diogo0001/PI_III/cronograma.md

## Cronograma de atividades

| | Semana 1 | Semana 2 | Semana 3 | Semana 4 | Semana 5 |
|---|---|---|---|---|---|
|Setembro| Freq PWM stm32 (p/ VCO) | Ler MIDI-RX stm32 / Alimentar VCO-CI com PWM  |MIDI-Notas stm32/ 2 CIs-somador  | Notas-PWM stm32 / VCF | X |
|Outubro | LFO  / Envelope VCF | Controles  / VCA  | Envelope VCA | Ajustes | Layout da placa do circuito |
|Novembro| Teste placa  | Ajustes  | Placa | Montagem  / Afinação final | X |
|Dezembro| |  |  |  |  |
