diogo0001/PI_III/STM32_docs_codes/esq stm.PNG

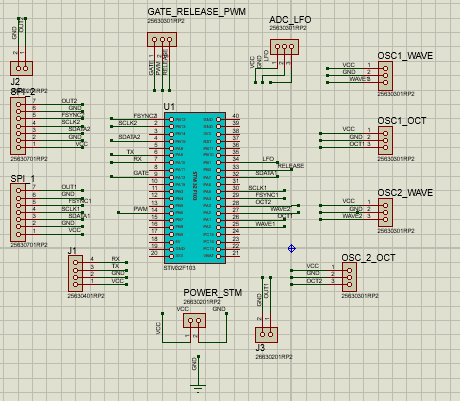
STM32_docs_codes/esq stm.PNG
