diogo0001/PI_III/Synth_docs_sources/LP_HP.jpg

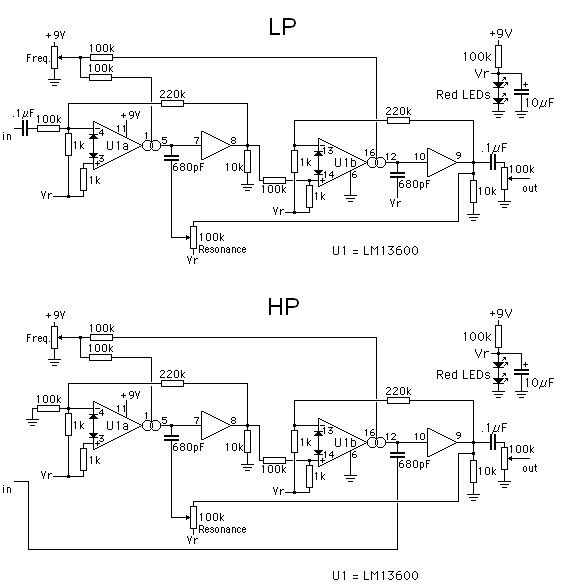
Synth_docs_sources/LP_HP.jpg
