diogo0001/PI_III/Synth_docs_sources/VCA/2cd8b64e2ba8f142182b0d7f99448446.png

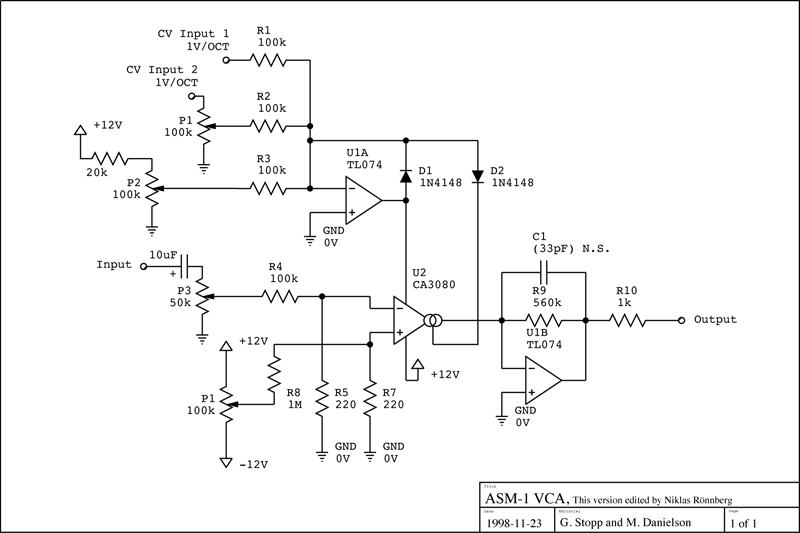
Synth_docs_sources/VCA/2cd8b64e2ba8f142182b0d7f99448446.png
