diogo0001/PI_III/Synth_docs_sources/VCA/110vca_645.gif

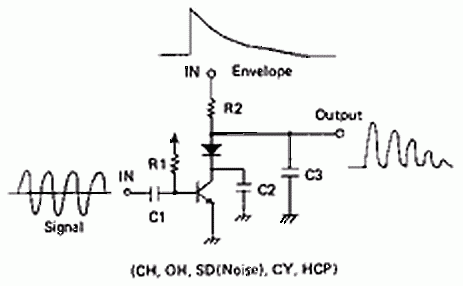
Synth_docs_sources/VCA/110vca_645.gif
