diogo0001/PI_III/Synth_docs_sources/VCA/ssm2164-dual-vca-schematic.png

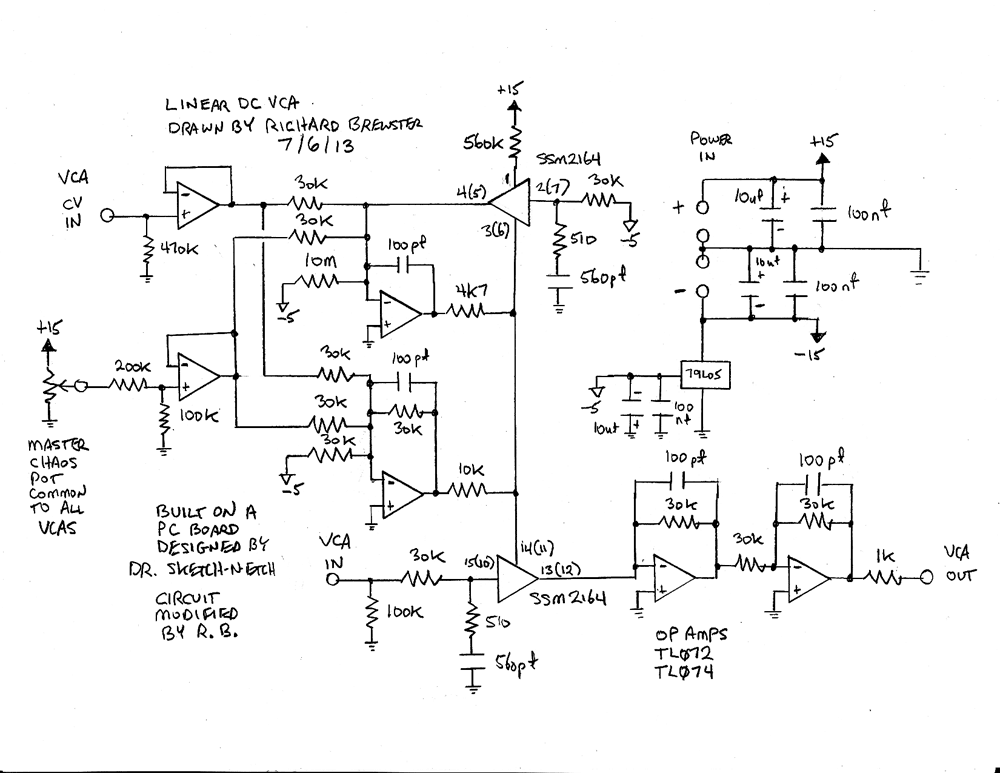
Synth_docs_sources/VCA/ssm2164-dual-vca-schematic.png
