diogo0001/PI_III/Synth_docs_sources/VCA/vca1.jpg

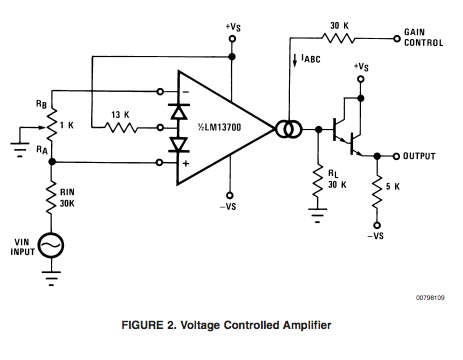
Synth_docs_sources/VCA/vca1.jpg
