diogo0001/PI_III/Synth_docs_sources/VCA/vca-f3.gif

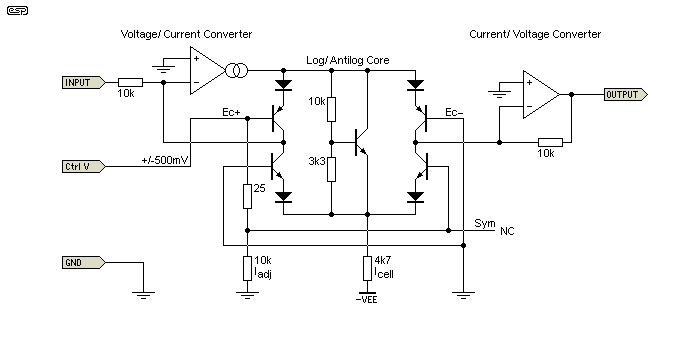
Synth_docs_sources/VCA/vca-f3.gif
