diogo0001/PI_III/Synth_docs_sources/VCA/YuVCASimplified.png

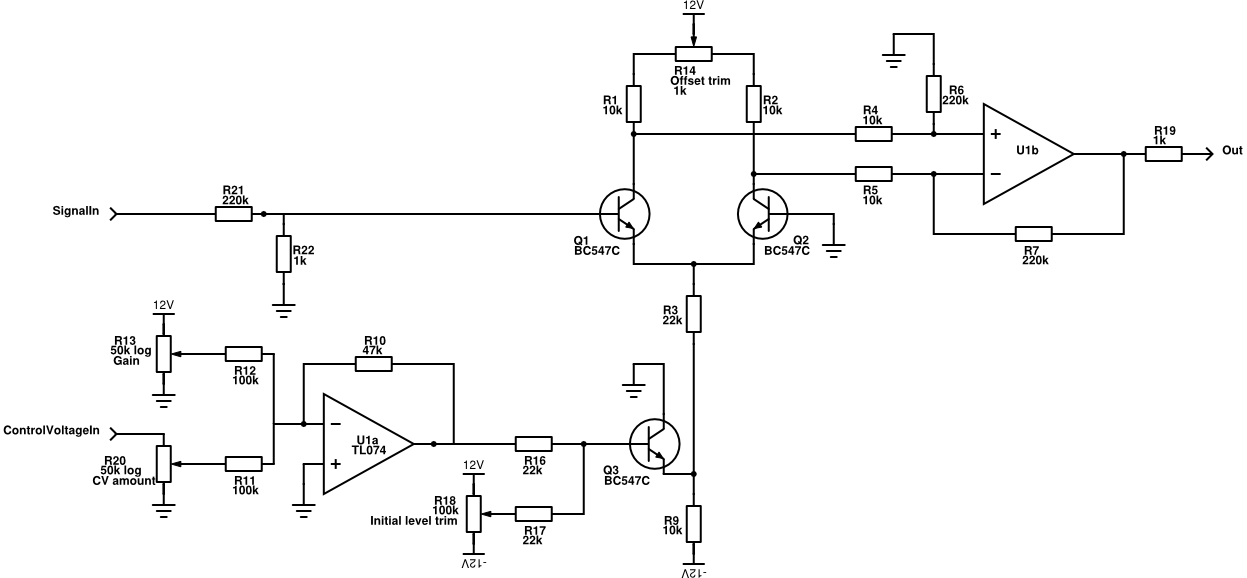
Synth_docs_sources/VCA/YuVCASimplified.png
