diogo0001/PI_III/Synth_docs_sources/Vcf0211a.gif

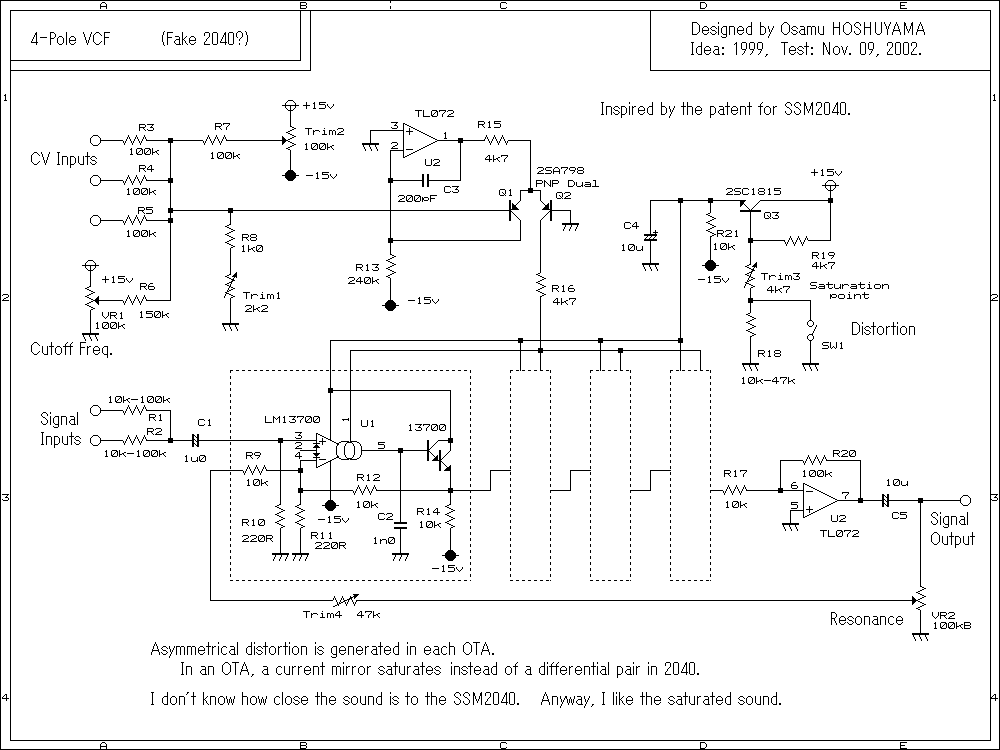
Synth_docs_sources/Vcf0211a.gif
