diogo0001/PI_III/Synth_docs_sources/VCF/t_ultrasimplevcf_132.png

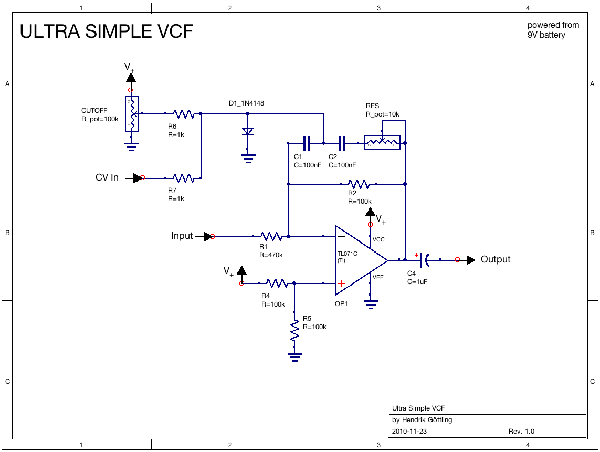
Synth_docs_sources/VCF/t_ultrasimplevcf_132.png
