diogo0001/PI_III/Synth_docs_sources/VCF/vcf.gif

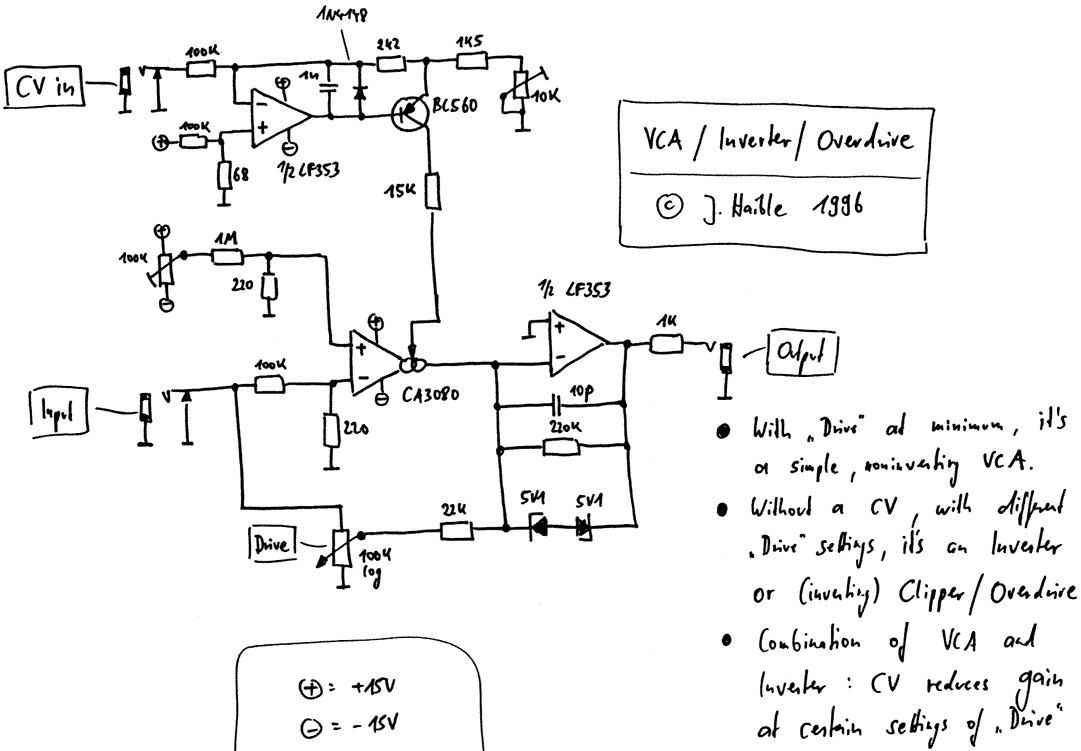
Synth_docs_sources/VCF/vcf.gif
