diogo0001/PI_III/Synth_docs_sources/VCF/vcf_sallen.gif

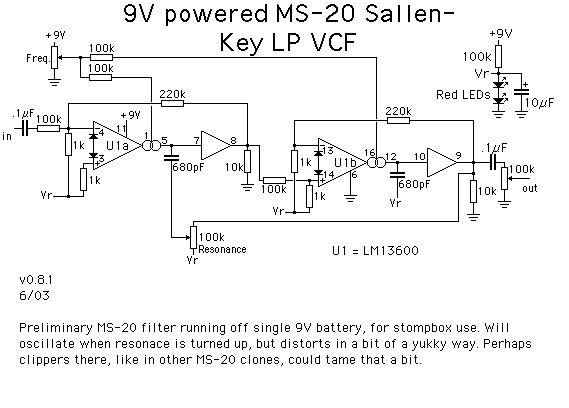
Synth_docs_sources/VCF/vcf_sallen.gif
