diogo0001/PI_III/Synth_docs_sources/VCF/vcfjan2006_schematic_pg2.gif

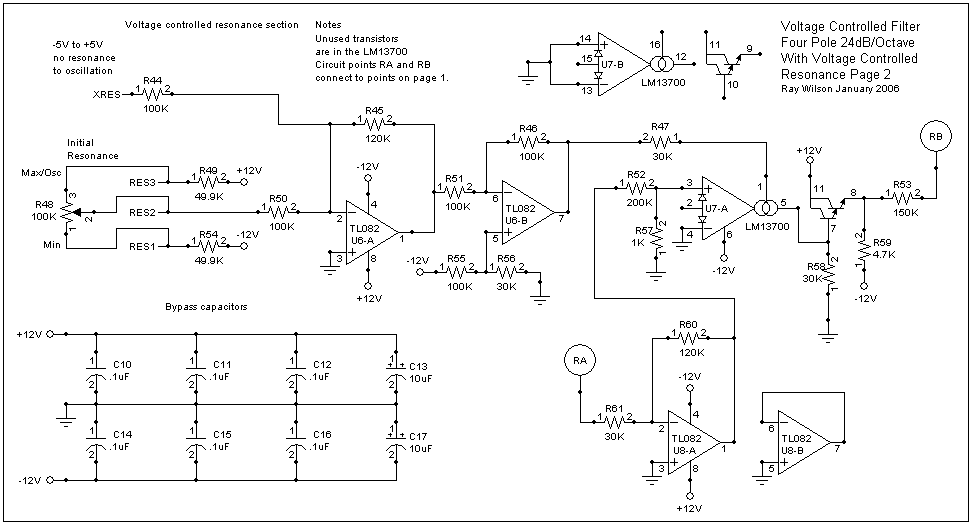
Synth_docs_sources/VCF/vcfjan2006_schematic_pg2.gif
