diogo0001/PI_III/VCA_test/readme.md

# Teste do circuito VCA

O circuito VCA é responsável pela amplificação final, e junto com o envelope produz as modulações 
de amplitude que podem caracterizar o som desejado. O circuito do envelope produz a envoltória que irá controlar
a dinâmica da amplitude do VCA em função do tempo. O VCA possui a entrada do sinal do áudio e a entrada 
para a tensão de controle, que virá do envelope e também do LFO.

Os parâmetros do envelope são:

  - Atack: tempo para o sinal atingir o seu máximo.
  - Decay: tempo para o sinal decair até a amplitude de sustain.
  - Sustain: amplitude de sustentação do sinal.
  - Release: tempo de decaimento do sustain até zero depois que a nota para de ser tocada.

## Circuito de simulação

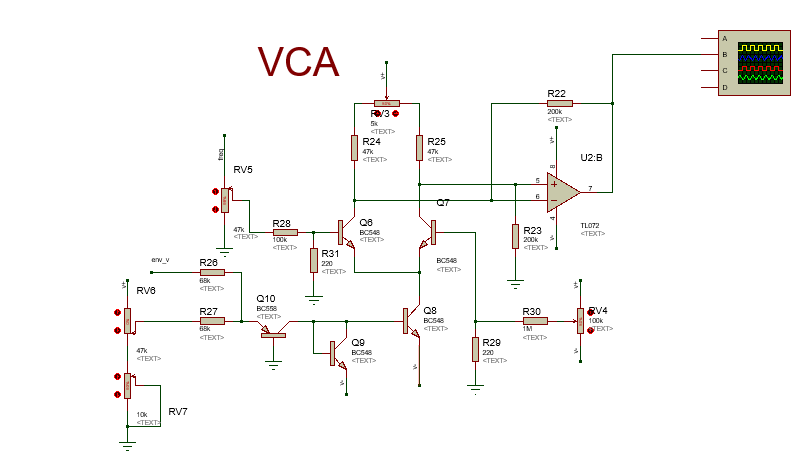
[picture p34: VCA_test/VCA_circuit.PNG]


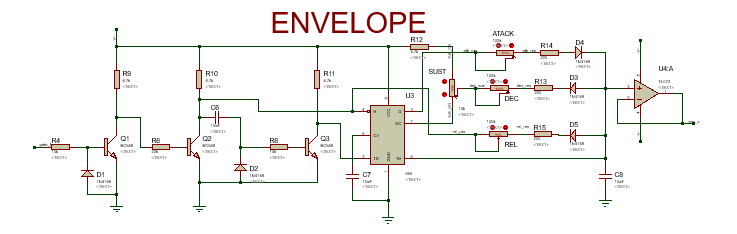
[picture p35: VCA_test/envelope_circuit.PNG]


### Resultado da simulação:

Em amarelo: sinal do envelope.

Em azul: sinal de áudio modulado.

Em rosa: sinal de áudio original.

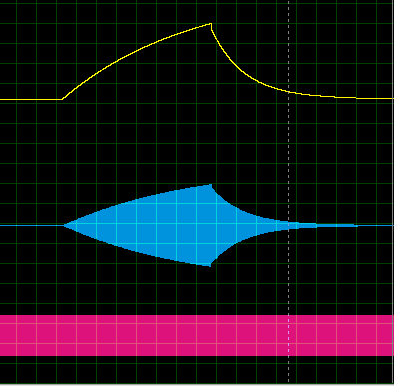
[picture p36: VCA_test/vca_envelope.PNG]


## Resultados práticos

### Envelope
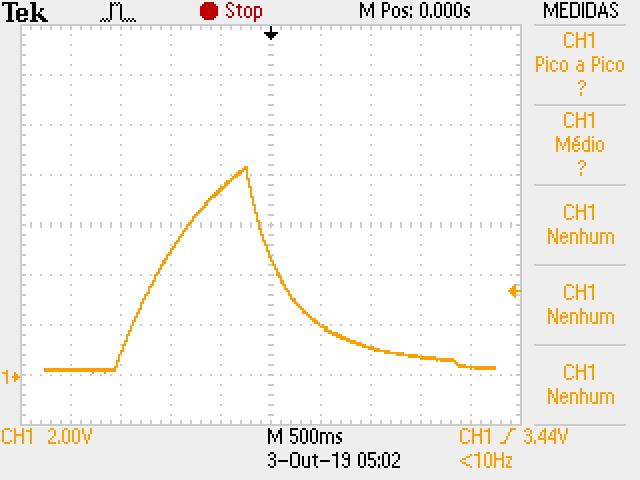
[picture p37: VCA_test/TEK0000.JPG]


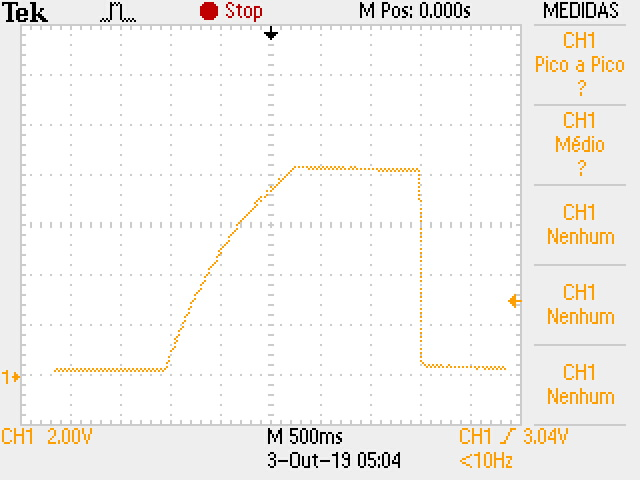
[picture p38: VCA_test/TEK0001.JPG]


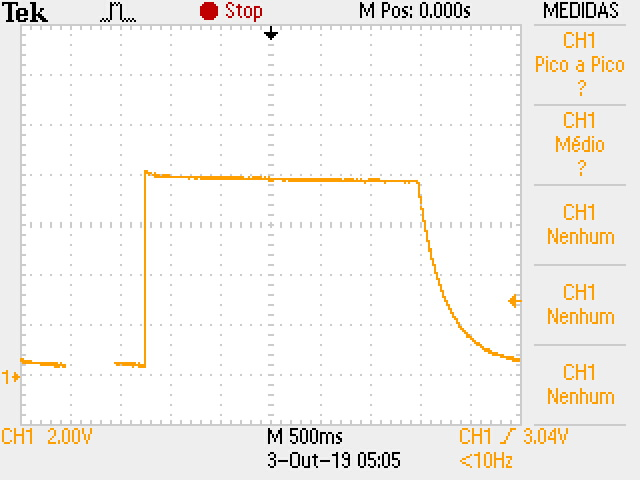
[picture p39: VCA_test/TEK0002.JPG]


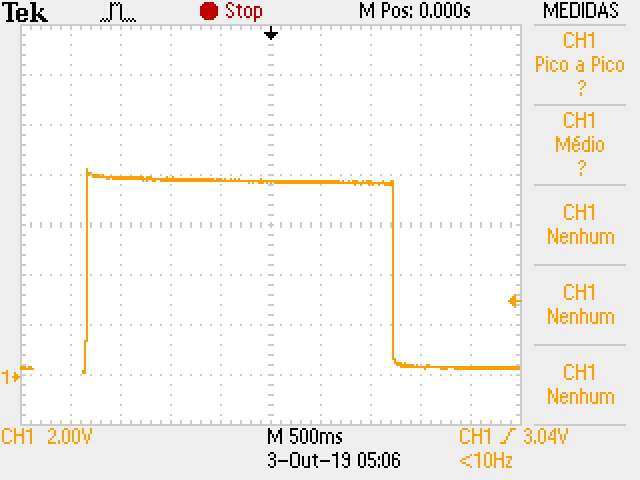
[picture p40: VCA_test/TEK0003.JPG]


### VCA

Teste do sinal com modulação por LFO

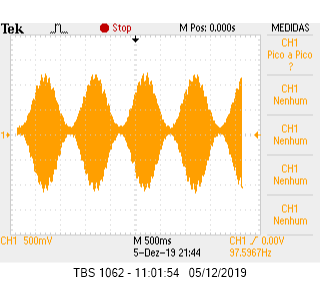
[picture p41: VCA_test/vca_lfo_osciloscope.png]
