diogo0001/PI_III/Board_layout/Layout_To_print/niveis_vcf.pdf

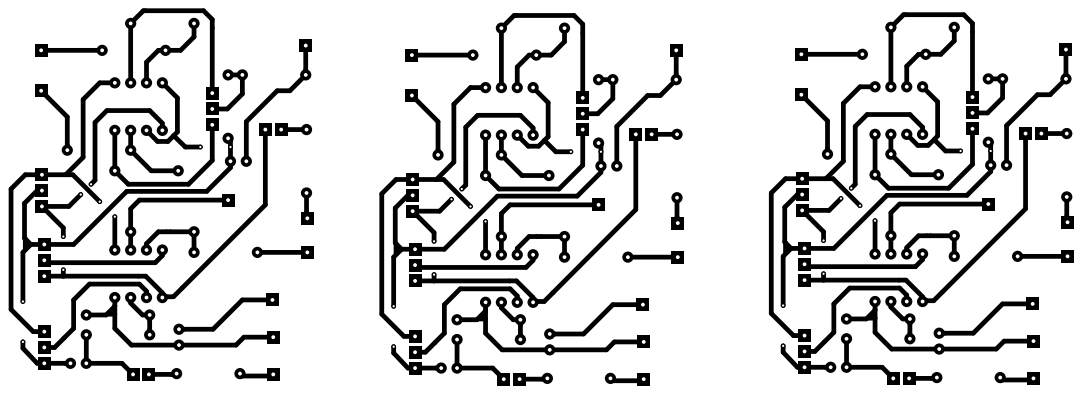
[picture p52: page 1]
