diogo0001/PI_III/Board_layout/Layout_To_print/niveis_vcf_silk.pdf

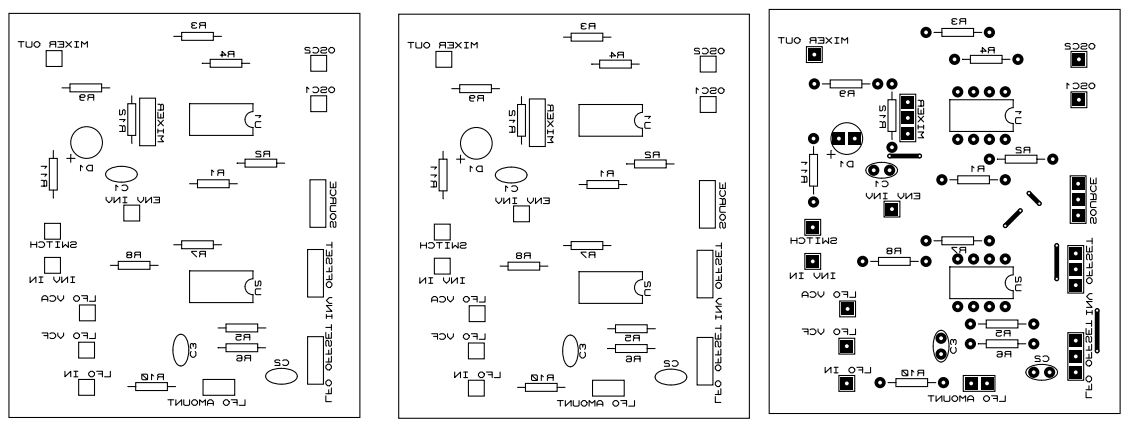
[picture p53: page 1]
