diogo0001/PI_III/Board_layout/Layout_To_print/vcf.pdf

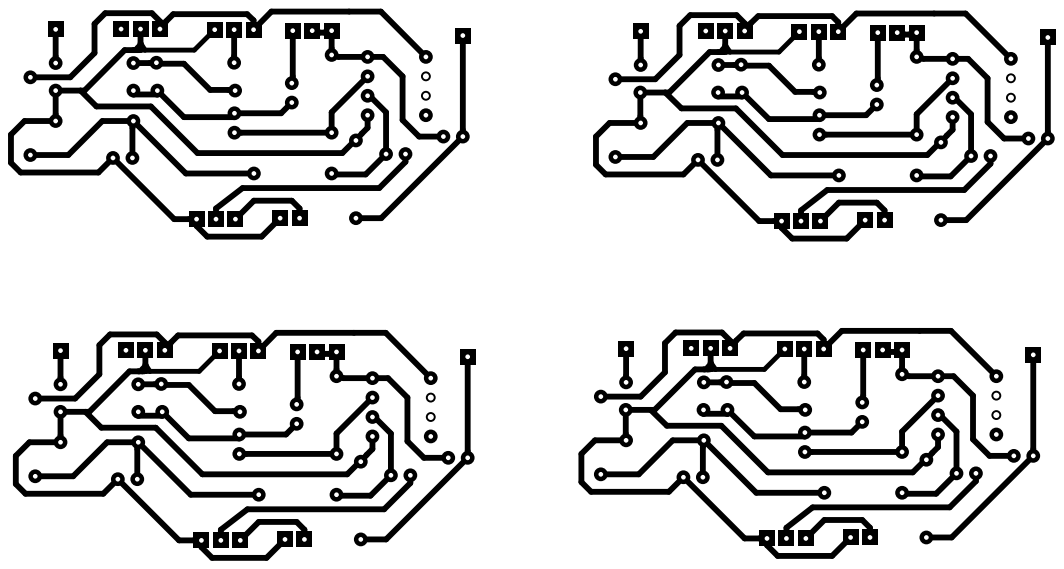
[picture p54: page 1]
