diogo0001/PI_III/Board_layout/Layout_To_print/vcf_silk.pdf

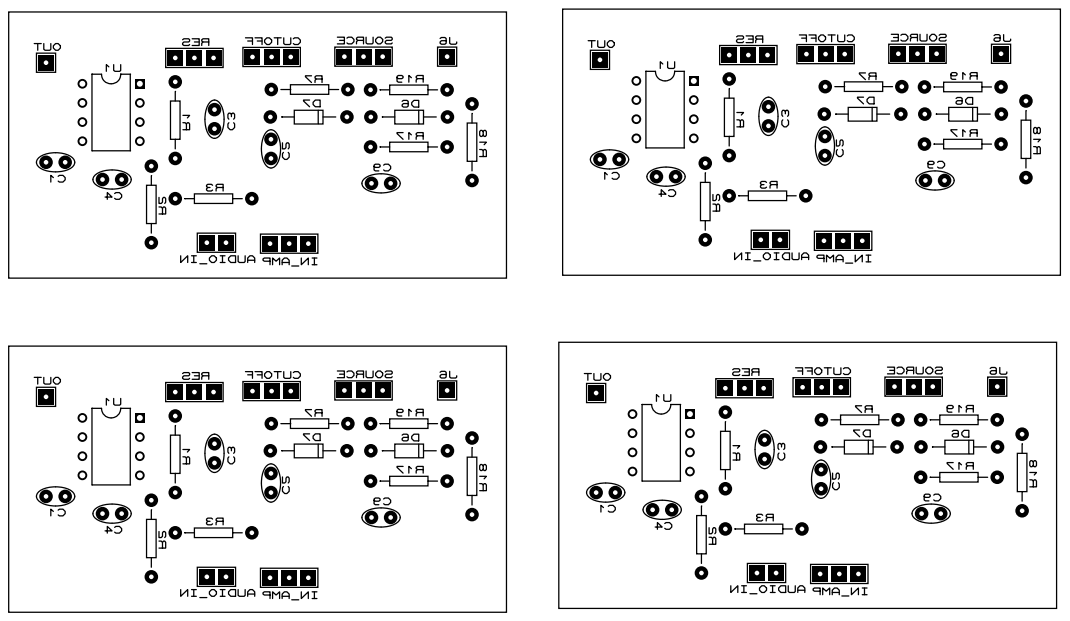
[picture p55: page 1]
