diogo0001/PI_III/Synth_docs_sources/VCF/DIRT_Schematic_2.2.pdf

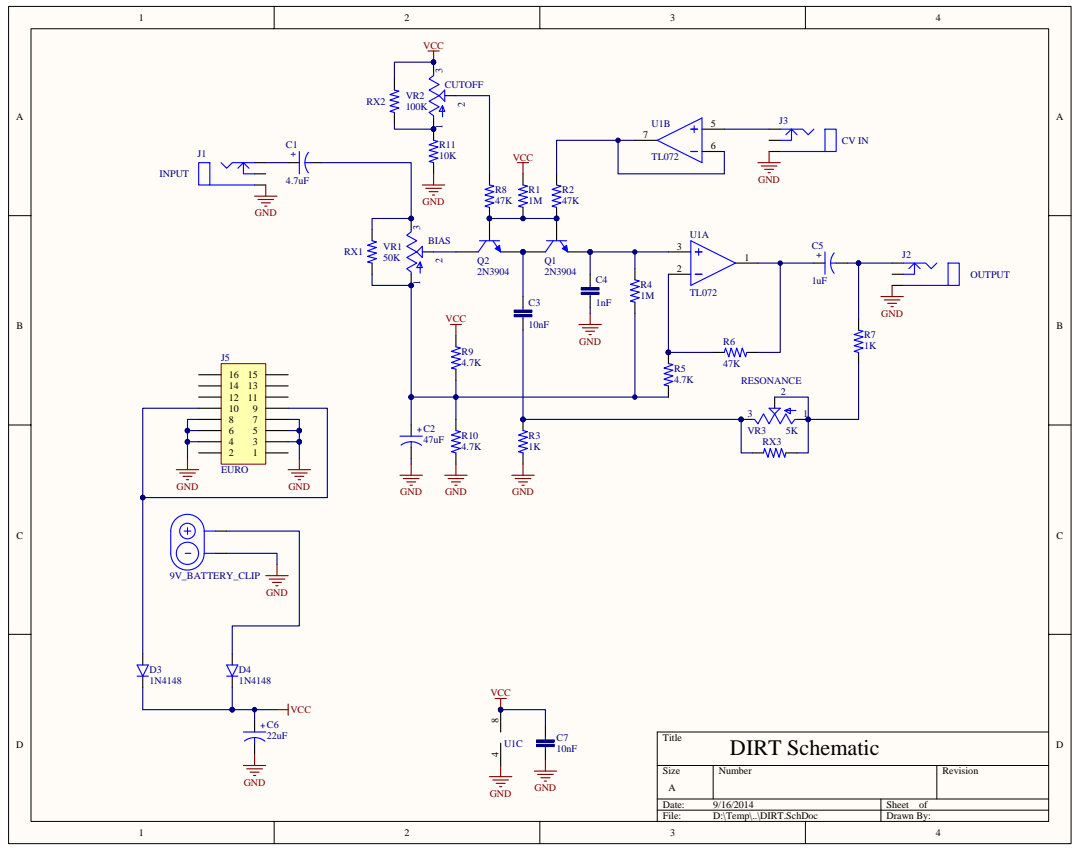
[picture p56: page 1]

Size A | Number | Revision

Date: 9/16/2014 | Sheet of
File: D:\Temp\..\DIRT.SchDoc | Drawn By:
