diogo0001/PI_III/Board_layout/Layout_To_print/vca.pdf

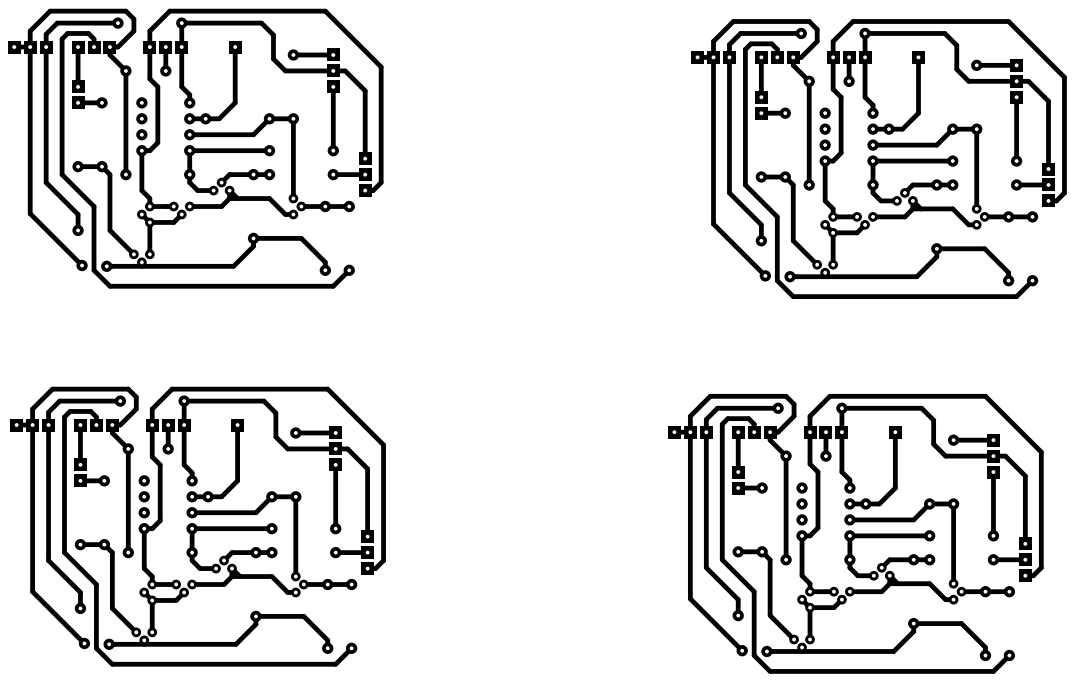
[picture p57: page 1]
