diogo0001/PI_III/Board_layout/Layout_To_print/vca_silk.pdf

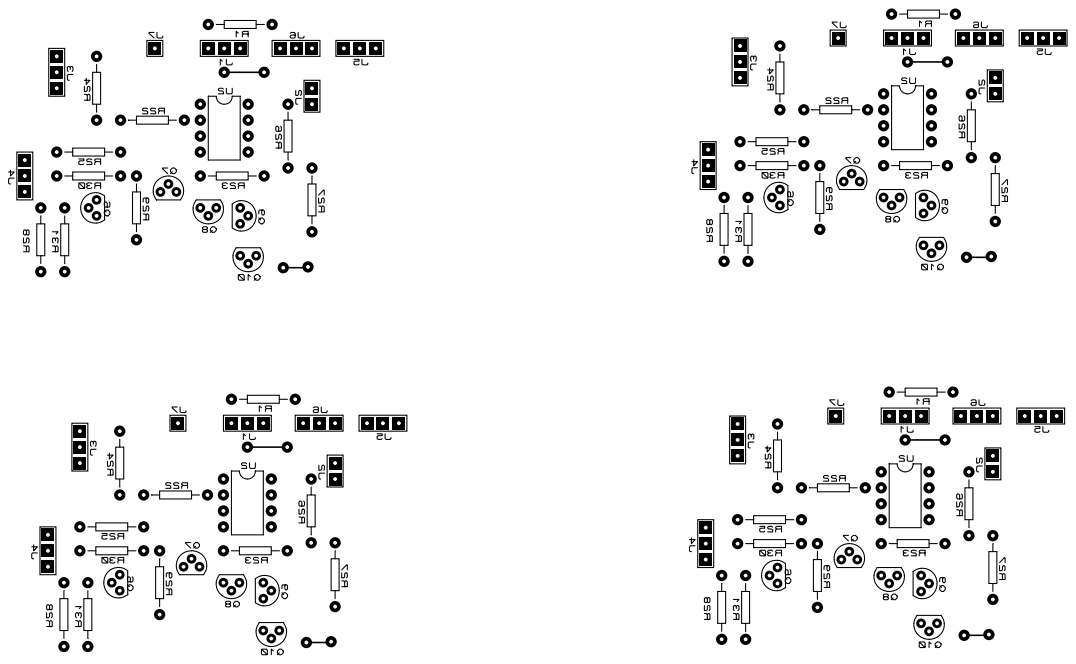
[picture p58: page 1]
