diogo0001/PI_III/Board_layout/Layout_To_print/envelope.pdf

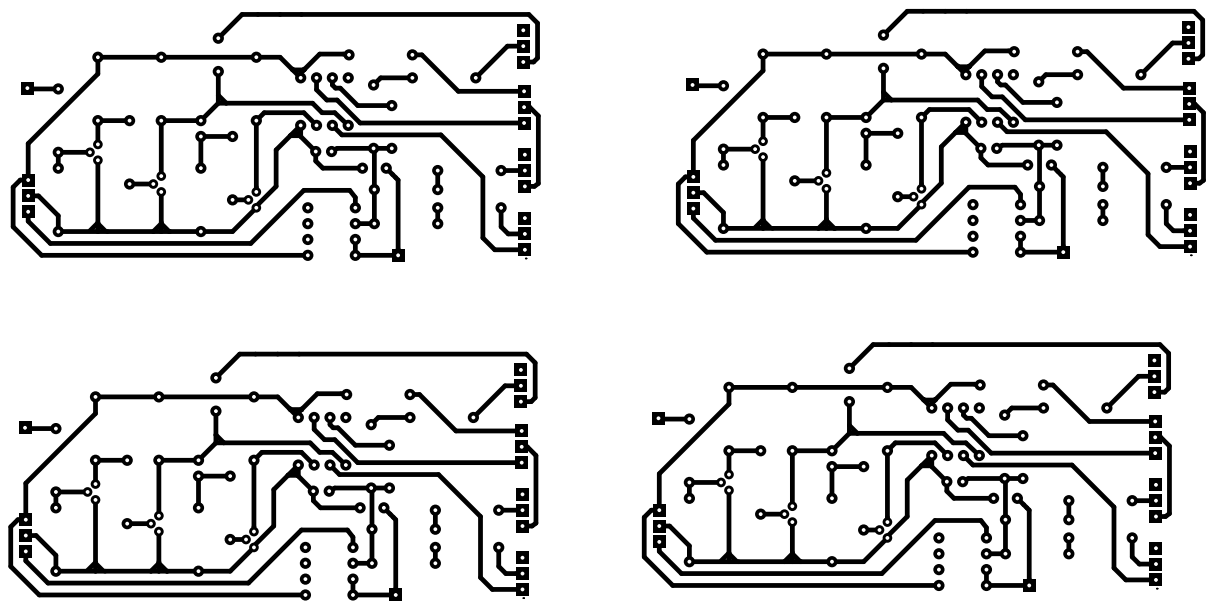
[picture p59: page 1]
