diogo0001/PI_III/Board_layout/Layout_To_print/envelope_silk.pdf

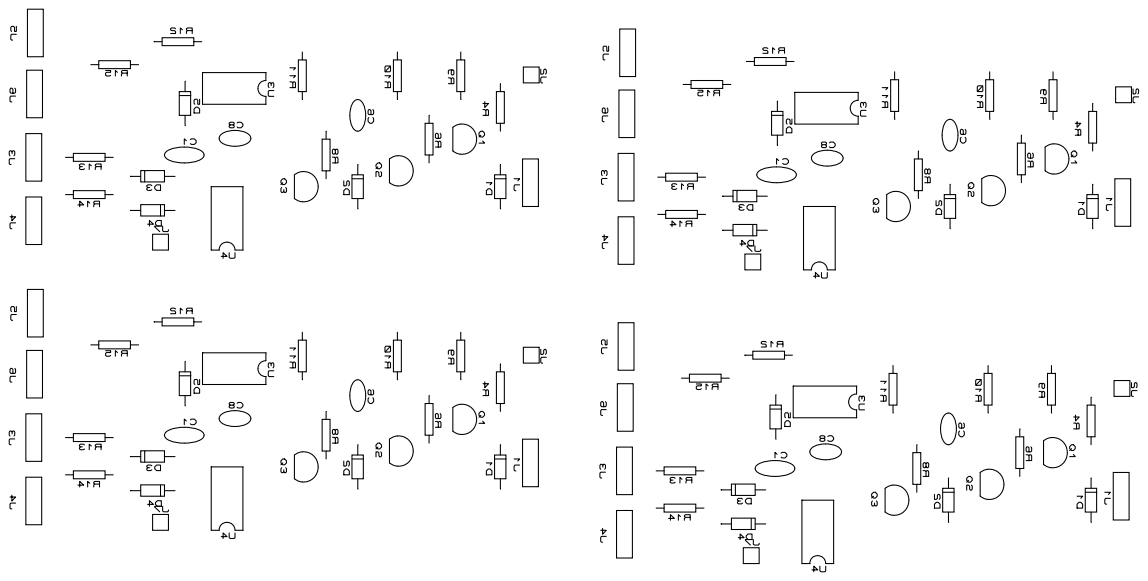
[picture p60: page 1]
