diogo0001/PI_III/STM32_docs_codes/code stm32.pdf

main.c

1 /* USER CODE BEGIN Header */
2 /**
3 ******************************************************************************
4 | * @file | : main.c
5 | * @brief | : Main program body
6 ****************************************************************************** 7 * @attention
8 *
9 * <h2><center>&copy; Copyright (c) 2019 STMicroelectronics.
10 * All rights reserved.</center></h2>
11 *
12 * This software component is licensed by ST under BSD 3-Clause license, 13 * the "License"; You may not use this file except in compliance with the 14 * License. You may obtain a copy of the License at:
15 | * | opensource.org/licenses/BSD-3-Clause
16 *
17 ****************************************************************************** 18 */
19 /* USER CODE END Header */
20
21 /* Includes ------------------------------------------------------------------*/ 22 #include "main.h"
23
24 /* Private includes ----------------------------------------------------------*/ 25 /* USER CODE BEGIN Includes */
26 #include "math.h"
27 /* USER CODE END Includes */
28
29 /* Private typedef -----------------------------------------------------------*/ 30 /* USER CODE BEGIN PTD */
31
32 /* USER CODE END PTD */
33
34 /* Private define ------------------------------------------------------------*/ 35 /* USER CODE BEGIN PD */
36
37 /* USER CODE END PD */
38
39 /* Private macro -------------------------------------------------------------*/ 40 /* USER CODE BEGIN PM */
41
42 /* USER CODE END PM */
43
44 /* Private variables ---------------------------------------------------------*/ 45 ADC_HandleTypeDef hadc1;
46 ADC_HandleTypeDef hadc2;
47
48 SPI_HandleTypeDef hspi1; 49 SPI_HandleTypeDef hspi2; 50
51 TIM_HandleTypeDef htim3; 52 TIM_HandleTypeDef htim4;
53
54 UART_HandleTypeDef huart1;
55 DMA_HandleTypeDef hdma_usart1_rx; 56 DMA_HandleTypeDef hdma_usart1_tx; 57
58 /* USER CODE BEGIN PV */
59
60 /* USER CODE END PV */
61
62 /* Private function prototypes -----------------------------------------------*/
| | Page 1

main.c

63 void SystemClock_Config(void);
64 static void MX_GPIO_Init(void);
65 static void MX_DMA_Init(void);
66 static void MX_USART1_UART_Init(void); 67 static void MX_SPI1_Init(void);
68 static void MX_SPI2_Init(void);
69 static void MX_TIM3_Init(void);
70 static void MX_ADC1_Init(void); 71 static void MX_TIM4_Init(void); 72 static void MX_ADC2_Init(void); 73 /* USER CODE BEGIN PFP */
74
75 typedef uint32_t u32;
76 const float refFreq = 25000000.0;
77

### 78 void StartDefaultTask(void); //função para principal -

79 void AD9833reset(void); | // reseta o ad

### 80 void WriteRegister (uint16_t data,uint16_t data2); // SPI para os registradores do AD

81 void delay_us(u32 nus);
82 void AD9833setNote(uint16_t frequency); // recebe protocolo midi pela uart e aciona o ad com a frequencia

### 83 uint16_t selectWave1(void); //seleciona forma de onda para o osc 01 84 uint16_t selectWave2(void); //seleciona forma de onda para o osc 02 85 uint16_t readLFO(void); // LFO nao finalizado ate o momento mas com pwm ja configurado

para posterior uso.
86
87 /* USER CODE END PFP */
88
89 /* Private user code ---------------------------------------------------------*/ 90 /* USER CODE BEGIN 0 */
91 int step = 0;
92 uint16_t pwm_value = 0;
93 void user_pwm_setvalue(uint16_t value); 94 uint8_t in[1];
95 uint8_t nt[1]; | // note
96 uint8_t vl[1]; | // velocity
97
98 char vt[4];
99 uint16_t notes[] = {16,17,18,19,20,110,22,23,24,27,29,30,33, 100 34,36,39,41,43,46,48,51,55,58,65,69,73,
101 77,82,87,92,97,103,110,116,123,130,138,
102 146,155,168,174,185,196,208,220,260,280,300,
103 | 310,340,360,390,400,410,440,480,500,520,540 | // frequências das
notas
104 };
105
106
107
108 /* USER CODE END 0 */
109
110 /**
111 * @brief The application entry point. 112 * @retval int
113 */
114 int main(void)
115 {
116 /* USER CODE BEGIN 1 */ 117
118 /* USER CODE END 1 */
119
120
121 /* MCU Configuration--------------------------------------------------------*/
| Page 2

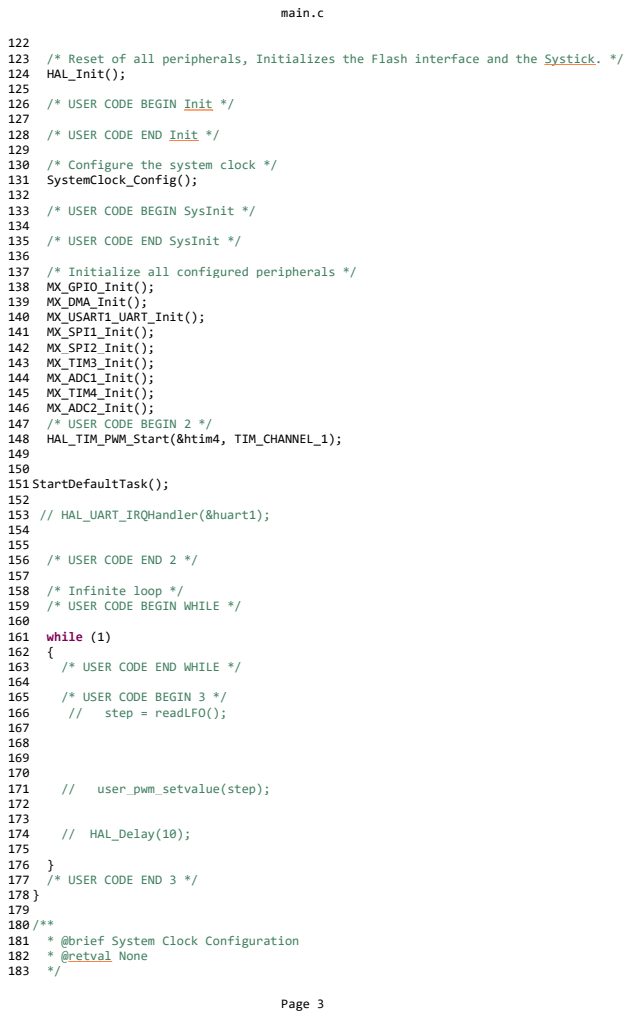
[picture p61: page 3]
main.c; 122 123 /* Reset of all peripherals, Initializes the Flash interface and the Systick. */ 124 HAL_Init(); 125 126 /* USER CODE BEGIN Init */ 127 128 /* USER CODE END Init */ 129 130 /* Configure the system clock */ 131 SystemClock_Config(); 132 133 /* USER CODE BEGIN SysInit */ 134 135 /* USER CODE END SysInit */ 136 137 /* Initialize all configured peripherals */ 138 MX_GPIO_Init(); 139 MX_DMA_Init(); 140 MX_USART1_UART_Init(); 141 MX_SPI1_Init(); 142 MX_SPI2_Init(); 143 MX_TIM3_Init()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

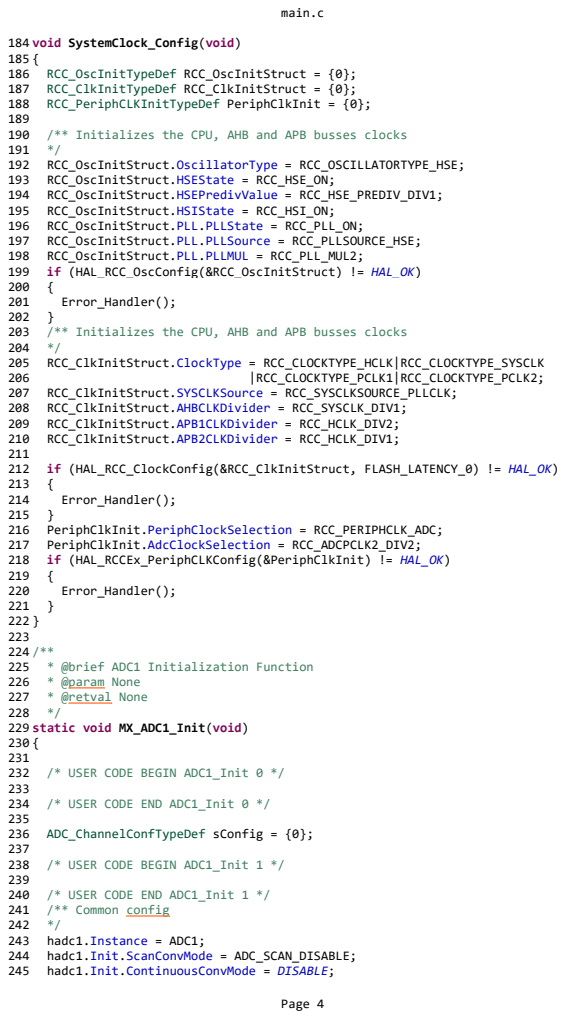
[picture p62: page 4]
main.c; 184 void SystemClock_Config(void) 185 { 186 RCC_OscInitTypeDef RCC_OscInitStruct = {0}; 187 RCC_ClkInitTypeDef RCC_ClkInitStruct = {0}; 188 RCC_PeriphCLKInitTypeDef PeriphClkInit = {0}; 189 190 /** Initializes the CPU, AHB and APB busses clocks 191 */ 192 RCC_OscInitStruct.OscillatorType = RCC_OSCILLATORTYPE_HSE; 193 RCC_OscInitStruct.HSEState = RCC_HSE_ON; 194 RCC_OscInitStruct.HSEPredivValue = RCC_HSE_PREDIV_DIV1; 195 RCC_OscInitStruct.HSIState = RCC_HSI_ON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

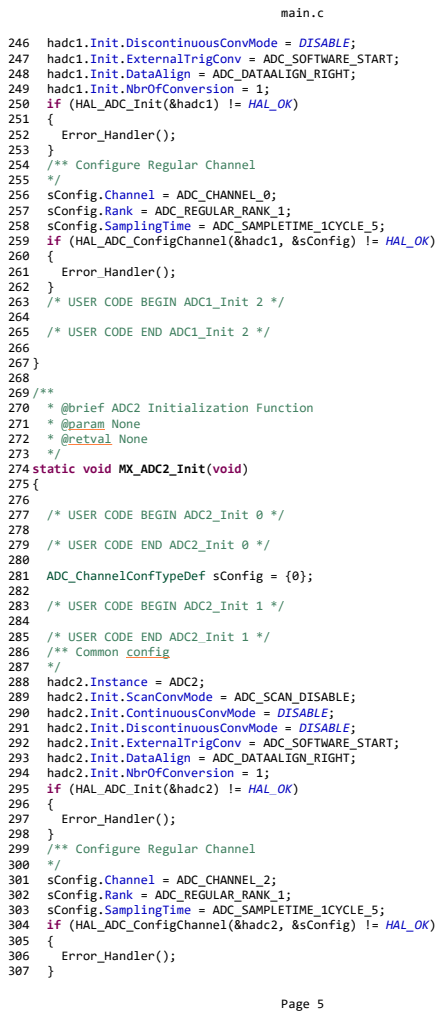
[picture p63: page 5]
main.c; 246 hadc1.Init.DiscontinuousConvMode = DISABLE; 247 hadc1.Init.ExternalTrigConv = ADC_SOFTWARE_START; 248 hadc1.Init.DataAlign = ADC_DATAALIGN_RIGHT; 249 hadc1.Init.NbrOfConversion = 1; 250 if (HAL_ADC_Init(&hadc1) != HAL_OK) 251 { 252 Error_Handler(); 253 } 254 /** Configure Regular Channel 255 */ 256 sConfig.Channel = ADC_CHANNEL_0; 257 sConfig.Rank = ADC_REGULAR_RANK_1; 258 sConfig.SamplingTime = ADC_SAMPLETIME_1CYCLE_5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

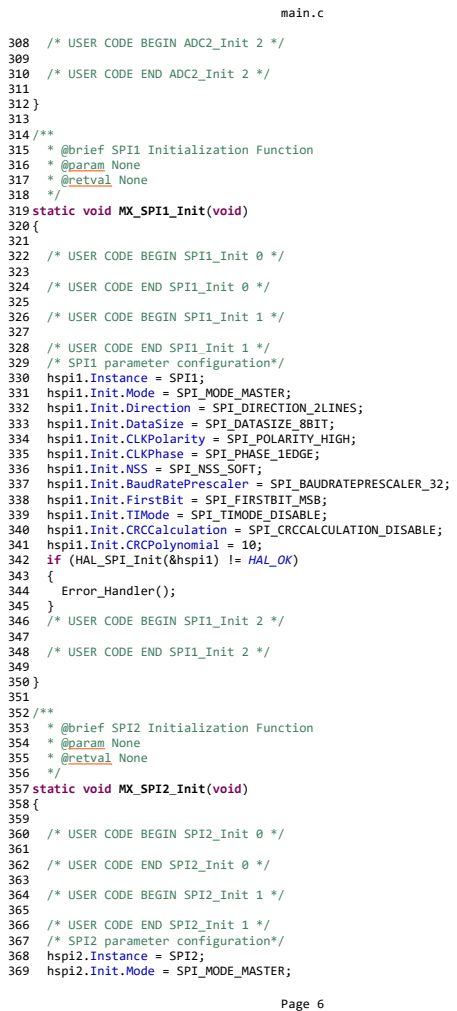
[picture p64: page 6]
main.c; 308 /* USER CODE BEGIN ADC2_Init 2 */ 309 310 /* USER CODE END ADC2_Init 2 */ 311 312 } 313 314 /** 315 * @brief SPI1 Initialization Function 316 * @param None 317 * @retval None 318 */ 319 static void MX_SPI1_Init(void) 320 { 321 322 /* USER CODE BEGIN SPI1_Init 0 */ 323 324 /* USER CODE END SPI1_Init 0 */ 325 326 /* USER CODE BEGIN SPI1_Init 1 */ 327 328 /* USER CODE END SPI1_Init 1 */ 329 /* SPI1 parameter configuration*/ 330 hspi1.Instance = SPI1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

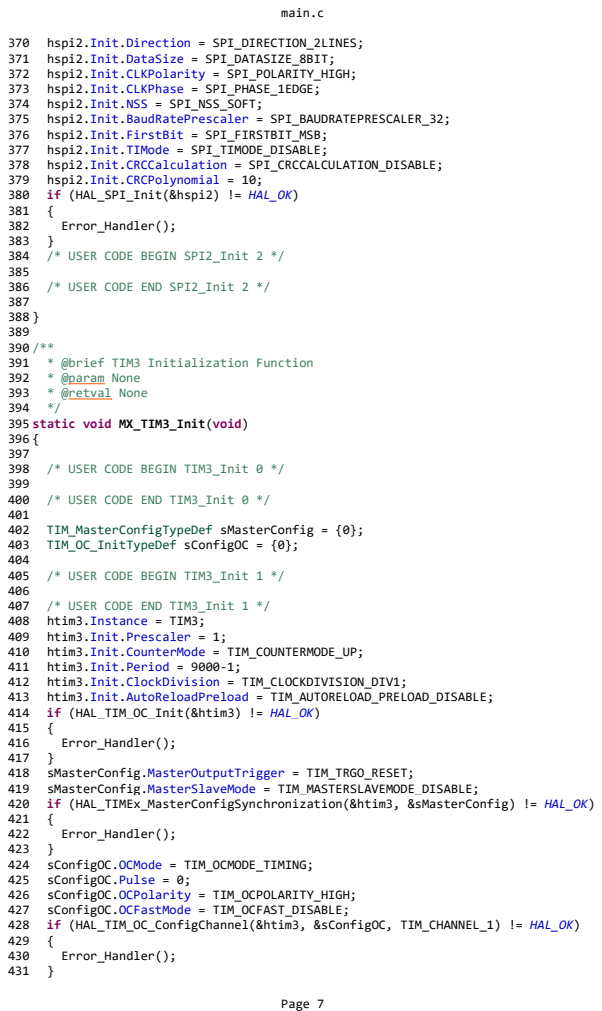
[picture p65: page 7]
main.c; 370 hspi2.Init.Direction = SPI_DIRECTION_2LINES; 371 hspi2.Init.DataSize = SPI_DATASIZE_8BIT; 372 hspi2.Init.CLKPolarity = SPI_POLARITY_HIGH; 373 hspi2.Init.CLKPhase = SPI_PHASE_1EDGE; 374 hspi2.Init.NSS = SPI_NSS_SOFT; 375 hspi2.Init.BaudRatePrescaler = SPI_BAUDRATEPRESCALER_32; 376 hspi2.Init.FirstBit = SPI_FIRSTBIT_MSB; 377 hspi2.Init.TIMode = SPI_TIMODE_DISABLE; 378 hspi2.Init.CRCCalculation = SPI_CRCCALCULATION_DISABLE; 379 hspi2.Init.CRCPolynomial = 10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

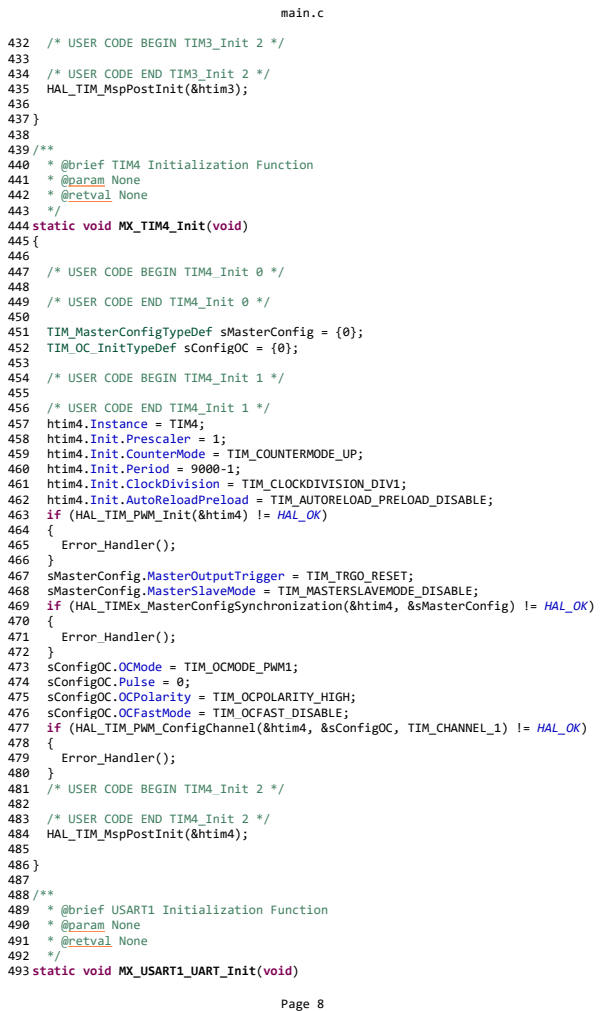
[picture p66: page 8]
main.c; 432 /* USER CODE BEGIN TIM3_Init 2 */ 433 434 /* USER CODE END TIM3_Init 2 */ 435 HAL_TIM_MspPostInit(&htim3); 436 437 } 438 439 /** 440 * @brief TIM4 Initialization Function 441 * @param None 442 * @retval None 443 */ 444 static void MX_TIM4_Init(void) 445 { 446 447 /* USER CODE BEGIN TIM4_Init 0 */ 448 449 /* USER CODE END TIM4_Init 0 */ 450 451 TIM_MasterConfigTypeDef sMasterConfig = {0}; 452 TIM_OC_InitTypeDef sConfigOC = {0}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

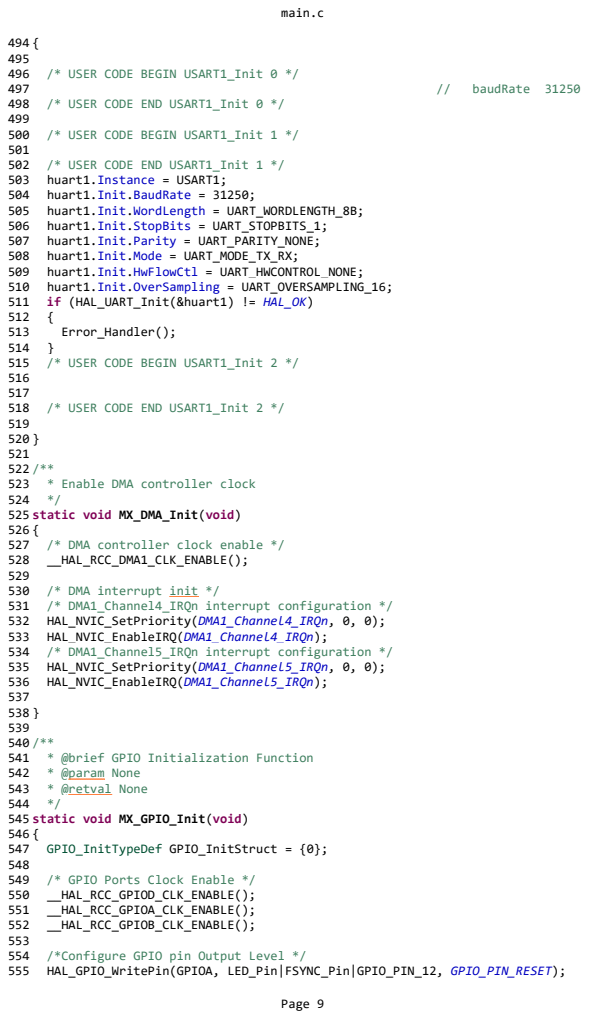
[picture p67: page 9]
main.c; 494 { 495 496 /* USER CODE BEGIN USART1_Init 0 */; baudRate 31250; 498 /* USER CODE END USART1_Init 0 */ 499 500 /* USER CODE BEGIN USART1_Init 1 */ 501 502 /* USER CODE END USART1_Init 1 */ 503 huart1.Instance = USART1; 504 huart1.Init.BaudRate = 31250; 505 huart1.Init.WordLength = UART_WORDLENGTH_8B; 506 huart1.Init.StopBits = UART_STOPBITS_1; 507 huart1.Init.Parity = UART_PARITY_NONE; 508 huart1.Init.Mode = UART_MODE_TX_RX; 509 huart1.Init.HwFlowCtl = UART_HWCONTROL_NONE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

main.c

556
557 /*Configure GPIO pin Output Level */
558 HAL_GPIO_WritePin(GPIOB, GT_NOTA_Pin|FSYNC2_Pin, GPIO_PIN_RESET); 559
560 /*Configure GPIO pin : WAVE1_Pin */
561 GPIO_InitStruct.Pin = WAVE1_Pin;
562 GPIO_InitStruct.Mode = GPIO_MODE_ANALOG;
563 HAL_GPIO_Init(WAVE1_GPIO_Port, &GPIO_InitStruct); 564
565 /*Configure GPIO pins : LED_Pin FSYNC_Pin PA12 */ 566 GPIO_InitStruct.Pin = LED_Pin|FSYNC_Pin|GPIO_PIN_12; 567 GPIO_InitStruct.Mode = GPIO_MODE_OUTPUT_PP;
568 GPIO_InitStruct.Pull = GPIO_NOPULL;
569 GPIO_InitStruct.Speed = GPIO_SPEED_FREQ_LOW;
570 HAL_GPIO_Init(GPIOA, &GPIO_InitStruct);
571
572 /*Configure GPIO pins : GT_NOTA_Pin FSYNC2_Pin */ 573 GPIO_InitStruct.Pin = GT_NOTA_Pin|FSYNC2_Pin; 574 GPIO_InitStruct.Mode = GPIO_MODE_OUTPUT_PP;
575 GPIO_InitStruct.Pull = GPIO_NOPULL;
576 GPIO_InitStruct.Speed = GPIO_SPEED_FREQ_LOW; 577 HAL_GPIO_Init(GPIOB, &GPIO_InitStruct); 578
579 /*Configure GPIO pin : LFO_Pin */
580 GPIO_InitStruct.Pin = LFO_Pin;
581 GPIO_InitStruct.Mode = GPIO_MODE_ANALOG;
582 HAL_GPIO_Init(LFO_GPIO_Port, &GPIO_InitStruct); 583
584 /*Configure GPIO pin : PA8 */
585 GPIO_InitStruct.Pin = GPIO_PIN_8;
586 GPIO_InitStruct.Mode = GPIO_MODE_AF_PP; 587 GPIO_InitStruct.Speed = GPIO_SPEED_FREQ_LOW; 588 HAL_GPIO_Init(GPIOA, &GPIO_InitStruct); 589
590 }
591
592 /* USER CODE BEGIN 4 */
593
594 void HAL_UART_RxCpltCallback(UART_HandleTypeDef *huart) 595 {
596 __NOP(); //check if we receive all data
597
598 }
599
600 void user_pwm_setvalue(uint16_t value) 601 {
602 TIM_OC_InitTypeDef sConfigOC;
603
604 sConfigOC.OCMode = TIM_OCMODE_PWM1;
605 sConfigOC.Pulse = value;
606 sConfigOC.OCPolarity = TIM_OCPOLARITY_HIGH;
607 sConfigOC.OCFastMode = TIM_OCFAST_DISABLE;
608 | HAL_TIM_PWM_ConfigChannel(&htim4, &sConfigOC, TIM_CHANNEL_1); | // pwm
609 | HAL_TIM_PWM_Start(&htim4, TIM_CHANNEL_1); | //pwm
610 }
611
612
613
614 void delay_us(u32 nus) 615 {
616 u32 temp;
617 while(nus--)
| Page 10

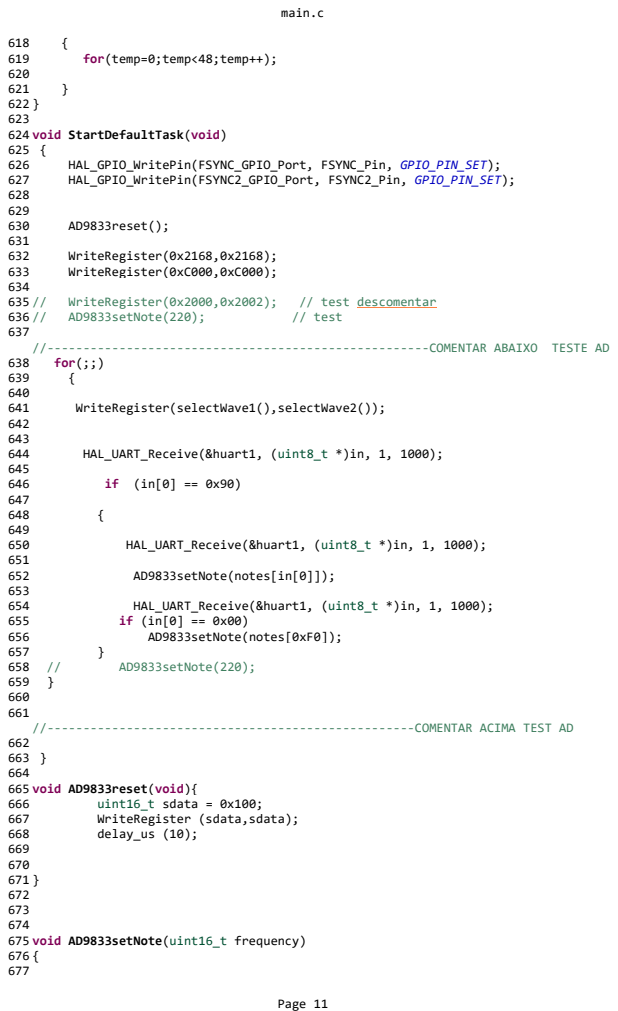
[picture p68: page 11]
main.c; 618 { 619 for(temp=0;temp<48;temp++); 620 621 } 622 } 623 624 void StartDefaultTask(void) 625 { 626 HAL_GPIO_WritePin(FSYNC_GPIO_Port, FSYNC_Pin, GPIO_PIN_SET); 627 HAL_GPIO_WritePin(FSYNC2_GPIO_Port, FSYNC2_Pin, GPIO_PIN_SET); 628 629 630 AD9833reset(); 631 632 WriteRegister(0x2168,0x2168); 633 WriteRegister(0xC000,0xC000); 634; WriteRegister(0x2000,0x2002);; // test descomentar; AD9833setNote(220);; // test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

main.c

678 long FreqWord = (frequency * pow(2, 28)) / refFreq;
679
680 | uint16_t MSB = ((FreqWord & 0xFFFC000) >> 14); | //Only lower 14 bits are used
for data
681 uint16_t LSB = (FreqWord & 0x3FFF);
682
683 //Set control bits 15 ande 14 to 0 and 1, respectively, for frequency register 0 684 LSB |= 0x4000;
685 MSB |= 0x4000;
686
687 | WriteRegister(LSB,LSB); | // Write lower 16 bits to AD9833
registers
688 | WriteRegister(MSB,MSB); | // Write upper 16 bits to AD9833
registers.
689 // Exit & Reset to SINE, SQUARE or TRIANGLE 690
691
692 }
693
694 void WriteRegister (uint16_t data, uint16_t data2){ 695
696
697
698 | uint8_t | spi_tx_LB = (uint8_t) data; //Low Byte ;
699 | uint8_t | spi_tx_MB = | data >> 8 ; //High Byte;
700
701 | uint8_t | spi_tx_LB2 = (uint8_t) data2; //Low Byte ;
702 | uint8_t | spi_tx_MB2 = | data2 >> 8 ; //High Byte;
703
704
705
706 HAL_GPIO_WritePin(FSYNC_GPIO_Port, FSYNC_Pin, GPIO_PIN_RESET); 707 HAL_GPIO_WritePin(FSYNC2_GPIO_Port, FSYNC2_Pin, GPIO_PIN_RESET); 708 delay_us (10);
709
710
711 HAL_SPI_Transmit(&hspi1, &spi_tx_MB, 1, 1000); 712 HAL_SPI_Transmit(&hspi1, &spi_tx_LB, 1, 1000); 713
714 HAL_SPI_Transmit(&hspi2, &spi_tx_MB2, 1, 1000); 715 HAL_SPI_Transmit(&hspi2, &spi_tx_LB2, 1, 1000); 716
717
718 delay_us (10);
719
720 HAL_GPIO_WritePin(FSYNC_GPIO_Port, FSYNC_Pin, GPIO_PIN_SET); 721 HAL_GPIO_WritePin(FSYNC2_GPIO_Port, FSYNC2_Pin, GPIO_PIN_SET);
722
723
724 ////////////////////////////////////////////////////////////////////////////////// 725
726
727 }
728
729 uint16_t selectWave1(void){ 730
731 uint32_t analog_val_1 = 0;
732
733 ///////////////////////////////ESCOLHE O TIPO DE ONDA OSCILADOR 1////////////////////////////////////////////////////////
734
735 for(;;)
| | | Page 12

main.c

736 {
737 HAL_ADC_Start(&hadc1);
738
739 if (HAL_ADC_PollForConversion(&hadc1, 1000000) == HAL_OK) 740 {
741 analog_val_1 = HAL_ADC_GetValue(&hadc1); 742 if (analog_val_1 <= 1342)
743 | return 0x2000; | //SINE
744 else{
745 if (analog_val_1 <= 2684){
746 | return 0x2002; | // TRIANGLE
747 }
748 else{
749 | return 0x2028; | // SQUARE
750 }
751 }
752
753 }
754
755
756
757 }
758 }
759
760 uint16_t selectWave2(void){ 761
762 uint32_t analog_val_1 = 0;
763
764 ///////////////////////////////ESCOLHE O TIPO DE ONDA OSCILADOR 2////////////////////////////////////////////////////////
765
766 for(;;)
767 {
768 HAL_ADC_Start(&hadc2);
769
770 if (HAL_ADC_PollForConversion(&hadc2, 1000000) == HAL_OK) 771 {
772 analog_val_1 = HAL_ADC_GetValue(&hadc2); 773 if (analog_val_1 <= 1342)
774 | return 0x2000; | //SINE
775 else{
776 if (analog_val_1 <= 2684){
777 | return 0x2002; | // TRIANGLE
778 }
779 else{
780 | return 0x2028; | // SQUARE
781 }
782 }
783
784 }
785
786 }
787 }
788
789
790
791
792
793 /* USER CODE END 4 */
794
795 /**
796 * @brief This function is executed in case of error occurrence.
| Page 13

main.c

797 * @retval None
798 */
799 void Error_Handler(void)
800 {
801 /* USER CODE BEGIN Error_Handler_Debug */
802 /* User can add his own implementation to report the HAL error return state */ 803
804 /* USER CODE END Error_Handler_Debug */
805 }
806
807 #ifdef USE_FULL_ASSERT
808 /**
809 * @brief Reports the name of the source file and the source line number
810 * | where the assert_param error has occurred.
811 * @param file: pointer to the source file name
812 * @param line: assert_param error line source number
813 * @retval None
814 */
815 void assert_failed(uint8_t *file, uint32_t line)
816 {
817 /* USER CODE BEGIN 6 */
818 /* User can add his own implementation to report the file name and line number, 819 tex: printf("Wrong parameters value: file %s on line %d\r\n", file, line) */ 820 /* USER CODE END 6 */
821 }
822 #endif /* USE_FULL_ASSERT */
823
824 /************************ (C) COPYRIGHT STMicroelectronics *****END OF FILE****/ 825

Page 14
