diogo0001/PI_III/(list of files, drawings)

Other design files:
Board_layout/Control_layout.pdsprj
Board_layout/envelope_layout.pdsprj
Board_layout/Placa_nivelamento.pdsprj
Board_layout/vca_layout.pdsprj
Board_layout/vcf_layout.pdsprj
ICL8039_PWM_test/PI_synth.pdsprj
VCA_test/PI_synth_vcs.pdsprj
VCA_test/PI_synth_vcs_backup.pdsprj
VCA_test/vca_led.pdsprj
VCF_test/synth_vcf.pdsprj
VCF_test/vcf_only.pdsprj
