diogo0001/PI_III/STM32_docs_codes/main.c

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

/* Includes ------------------------------------------------------------------*/
#include "main.h"

/* USER CODE BEGIN Includes */
#include "math.h"
/* USER CODE END Includes */

ADC_HandleTypeDef hadc1;
ADC_HandleTypeDef hadc2;

SPI_HandleTypeDef hspi1;
SPI_HandleTypeDef hspi2;

TIM_HandleTypeDef htim3;
TIM_HandleTypeDef htim4;

UART_HandleTypeDef huart1;
DMA_HandleTypeDef hdma_usart1_rx;
DMA_HandleTypeDef hdma_usart1_tx;

void SystemClock_Config(void);
static void MX_GPIO_Init(void);
static void MX_DMA_Init(void);
static void MX_USART1_UART_Init(void);
static void MX_SPI1_Init(void);
static void MX_SPI2_Init(void);
static void MX_TIM3_Init(void);
static void MX_ADC1_Init(void);
static void MX_TIM4_Init(void);
static void MX_ADC2_Init(void);
/* USER CODE BEGIN PFP */

typedef uint32_t u32;
const float refFreq = 25000000.0;

void StartDefaultTask(void);  //função para principal -
void AD9833reset(void);       // reseta o ad
void WriteRegister (uint16_t data,uint16_t data2); // SPI para os registradores do AD
void delay_us(u32 nus);
void AD9833setNote(uint16_t frequency); // recebe protocolo midi pela uart e aciona o ad com a frequencia
uint16_t selectWave1(void);  //seleciona forma de onda para o osc 01
uint16_t selectWave2(void);  //seleciona forma de onda para o osc 02
uint16_t  readLFO(void);  // LFO nao finalizado ate o momento mas com pwm ja configurado para posterior uso.

/* USER CODE END PFP */

/* USER CODE BEGIN 0 */
int step = 0;
uint16_t pwm_value = 0;
void user_pwm_setvalue(uint16_t value);
uint8_t in[1];
uint8_t nt[1];    // note
uint8_t vl[1];    // velocity

char vt[4];
uint16_t notes[] = {16,17,18,19,20,110,22,23,24,27,29,30,33,
                  34,36,39,41,43,46,48,51,55,58,65,69,73,
                  77,82,87,92,97,103,110,116,123,130,138,
                  146,155,168,174,185,196,208,220,260,280,300,
				  310,340,360,390,400,410,440,480,500,520,540          // frequências das notas
};



/* USER CODE END 0 */

/**
  * @brief  The application entry point.
  * @retval int
  */
int main(void)
{
  

  /* MCU Configuration--------------------------------------------------------*/

  /* Reset of all peripherals, Initializes the Flash interface and the Systick. */
  HAL_Init();

  /* Configure the system clock */
  SystemClock_Config();

  /* Initialize all configured peripherals */
  MX_GPIO_Init();
  MX_DMA_Init();
  MX_USART1_UART_Init();
  MX_SPI1_Init();
  MX_SPI2_Init();
  MX_TIM3_Init();
  MX_ADC1_Init();
  MX_TIM4_Init();
  MX_ADC2_Init();
  /* USER CODE BEGIN 2 */
  HAL_TIM_PWM_Start(&htim4, TIM_CHANNEL_1);


StartDefaultTask();

 // HAL_UART_IRQHandler(&huart1);


  /* USER CODE END 2 */

  /* Infinite loop */
  /* USER CODE BEGIN WHILE */

  while (1)
  {
    /* USER CODE END WHILE */

    /* USER CODE BEGIN 3 */
	 //   step = readLFO();




	//	 user_pwm_setvalue(step);


	//  HAL_Delay(10);

  }
  /* USER CODE END 3 */
}

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
/* USER CODE BEGIN 4 */

void HAL_UART_RxCpltCallback(UART_HandleTypeDef *huart)
{
	__NOP(); //check if we receive all data

}

void user_pwm_setvalue(uint16_t value)
  {
      TIM_OC_InitTypeDef sConfigOC;

      sConfigOC.OCMode = TIM_OCMODE_PWM1;
      sConfigOC.Pulse = value;
      sConfigOC.OCPolarity = TIM_OCPOLARITY_HIGH;
      sConfigOC.OCFastMode = TIM_OCFAST_DISABLE;
      HAL_TIM_PWM_ConfigChannel(&htim4, &sConfigOC, TIM_CHANNEL_1);     // pwm
      HAL_TIM_PWM_Start(&htim4, TIM_CHANNEL_1);                          //pwm
  }



void delay_us(u32 nus)
{
	u32 temp;
	while(nus--)
	{
	   for(temp=0;temp<48;temp++);

	}
}

void StartDefaultTask(void)
 {
	 HAL_GPIO_WritePin(FSYNC_GPIO_Port, FSYNC_Pin, GPIO_PIN_SET);
	 HAL_GPIO_WritePin(FSYNC2_GPIO_Port, FSYNC2_Pin, GPIO_PIN_SET);


	 AD9833reset();

	 WriteRegister(0x2168,0x2168);
	 WriteRegister(0xC000,0xC000);

//	 WriteRegister(0x2000,0x2002);   // test descomentar
//	 AD9833setNote(220);            // test
                                                  //-----------------------------------------------------COMENTAR ABAIXO  TESTE AD
   for(;;)
     {

	  WriteRegister(selectWave1(),selectWave2());


	   HAL_UART_Receive(&huart1, (uint8_t *)in, 1, 1000);

          if  (in[0] == 0x90)

	     {

	    	 HAL_UART_Receive(&huart1, (uint8_t *)in, 1, 1000);

        	  AD9833setNote(notes[in[0]]);

         	  HAL_UART_Receive(&huart1, (uint8_t *)in, 1, 1000);
        	if (in[0] == 0x00)
        		AD9833setNote(notes[0xF0]);
	     }
  //        AD9833setNote(220);
  }

                                                      //---------------------------------------------------COMENTAR ACIMA TEST AD

 }

void AD9833reset(void){
	     uint16_t sdata = 0x100;
	     WriteRegister (sdata,sdata);
	     delay_us (10);


}



void AD9833setNote(uint16_t frequency)
{

	 long FreqWord = (frequency * pow(2, 28)) / refFreq;

		  uint16_t MSB = ((FreqWord & 0xFFFC000) >> 14);    //Only lower 14 bits are used for data
		  uint16_t LSB = (FreqWord & 0x3FFF);

		  //Set control bits 15 ande 14 to 0 and 1, respectively, for frequency register 0
		  LSB |= 0x4000;
		  MSB |= 0x4000;

		  WriteRegister(LSB,LSB);                  // Write lower 16 bits to AD9833 registers
		  WriteRegister(MSB,MSB);                  // Write upper 16 bits to AD9833 registers.
		                               // Exit & Reset to SINE, SQUARE or TRIANGLE


}

void WriteRegister (uint16_t data, uint16_t data2){



	uint8_t   spi_tx_LB =  (uint8_t) data;  //Low Byte  ;
	uint8_t   spi_tx_MB =   data >> 8 ;  //High Byte;

	uint8_t   spi_tx_LB2 =  (uint8_t) data2;  //Low Byte  ;
	uint8_t   spi_tx_MB2 =   data2 >> 8 ;  //High Byte;



	 HAL_GPIO_WritePin(FSYNC_GPIO_Port, FSYNC_Pin, GPIO_PIN_RESET);
	 HAL_GPIO_WritePin(FSYNC2_GPIO_Port, FSYNC2_Pin, GPIO_PIN_RESET);
	 delay_us (10);


	    HAL_SPI_Transmit(&hspi1, &spi_tx_MB, 1, 1000);
	    HAL_SPI_Transmit(&hspi1, &spi_tx_LB, 1, 1000);

	    HAL_SPI_Transmit(&hspi2, &spi_tx_MB2, 1, 1000);
	    HAL_SPI_Transmit(&hspi2, &spi_tx_LB2, 1, 1000);


	    delay_us (10);

	HAL_GPIO_WritePin(FSYNC_GPIO_Port, FSYNC_Pin, GPIO_PIN_SET);
   HAL_GPIO_WritePin(FSYNC2_GPIO_Port, FSYNC2_Pin, GPIO_PIN_SET);


    //////////////////////////////////////////////////////////////////////////////////


}

uint16_t selectWave1(void){

	 uint32_t analog_val_1 = 0;

	 ///////////////////////////////ESCOLHE O TIPO DE ONDA OSCILADOR 1////////////////////////////////////////////////////////

	for(;;)
	 {
		 HAL_ADC_Start(&hadc1);

		 if (HAL_ADC_PollForConversion(&hadc1, 1000000) == HAL_OK)
		        {
			         analog_val_1 = HAL_ADC_GetValue(&hadc1);
			         if (analog_val_1 <= 1342)
			        	 return 0x2000;             //SINE
			         else{
			        	 if (analog_val_1 <= 2684){
		        		 return 0x2002;         // TRIANGLE
			        	 }
			        	 else{
			        		 return 0x2028;        // SQUARE
			        	 }
			         }

		        }



	 }
}

uint16_t selectWave2(void){

	 uint32_t analog_val_1 = 0;

	 ///////////////////////////////ESCOLHE O TIPO DE ONDA OSCILADOR 2////////////////////////////////////////////////////////

	for(;;)
	 {
		 HAL_ADC_Start(&hadc2);

		 if (HAL_ADC_PollForConversion(&hadc2, 1000000) == HAL_OK)
		        {
			         analog_val_1 = HAL_ADC_GetValue(&hadc2);
			         if (analog_val_1 <= 1342)
			        	 return 0x2000;             //SINE
			         else{
			        	 if (analog_val_1 <= 2684){
			        		 return 0x2002;         // TRIANGLE
			        	 }
			        	 else{
			        		 return 0x2028;        // SQUARE
			        	 }
			         }

		        }

	 }
}





/* USER CODE END 4 */
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
