diogo0001/PI_III/(commit log)

2019-08-01 Adicionado diagrama de blocos
2019-08-09 vcf vcd schematics
2019-08-14 Arduino pwm simulation and pdf docs
    [PI_synth.pdsprj]
2019-08-15 envelope adsr simulation
    [PI_synth.pdsprj]
2019-08-15 STM32 - pinout - datasheet
2019-08-15 update STM32 folder
2019-08-19 simulação pwm-filtro-ganho
    [PI_synth.pdsprj]
2019-08-19 Referencias pwm pra stm32
2019-08-19 arduino test pwm circuit
    [PI_synth.pdsprj]
2019-10-01 Layout vca
    [PI_synth_vcs.pdsprj, PI_synth_vcs_backup.pdsprj, envelope_layout.pdsprj, vca_layout.pdsprj]
2019-10-02 Envelope Layout
    [envelope_layout.pdsprj]
2019-10-02 Layout update
    [envelope_layout.pdsprj]
2019-10-02 Update envelope layout
    [envelope_layout.pdsprj]
2019-10-02 VCA test
    [PI_synth_vcs.pdsprj, synth_vcf.pdsprj]
2019-10-02 VCA circuit
    [PI_synth_vcs.pdsprj]
2019-10-02 Created organized directories
    [PI_synth_vcs_backup.pdsprj]
2019-10-03 Improvement in VCA
    [PI_synth_vcs.pdsprj]
2019-10-03 VCA layout
    [PI_synth_vcs.pdsprj, vca_layout.pdsprj]
2019-10-03 Change layout files to print folder
    [vca_layout.pdsprj]
2019-10-09 VCF simulation
    [synth_vcf.pdsprj]
2019-12-04 Teste key
    [Control_layout.pdsprj, envelope_layout.pdsprj, vcf_layout.pdsprj]
2019-12-10 VCA images osciloscope
    [PI_synth_vcs.pdsprj, vca_led.pdsprj]
